TheWarolf/Voron-Personal-Mods/README.md

# Voron-Personal-Mods
Personal modfications to Voron machines
