TheWarolf/Voron-Personal-Mods/Micron/Readme.md

This folder contains various mods for the Micron project.

Original Micron repo can be found [here](https://github.com/PrintersForAnts/Micron)
