TheWarolf/Voron-Personal-Mods/MMU/M4s-Battery-MMU/Readme.md

This an ancient thing, predating the ERCF development.
It was clunky, definitely bigger than needed and noisy af, but it was beautiful. It'll always have a place in my heart.

CAD that you find here is just to keep the memory alive. Do as you please with it, but consider that's a mess and incredibly incomplete. 
You've been warned.
