TheWarolf/Voron-Personal-Mods/V2/Long_Mantis_Toolhead/Readme.md

This folder contains a bunch of mods based on the awesome work made by discord user *Long* on his Mantis toolhead.
I've made just minimal mods, **all credit goes to him**.

Original repo can be found [here](https://github.com/mandryd/VoronUsers/tree/master/printer_mods/Long/Mantis_Dual_5015)
