TheWarolf/Voron-Personal-Mods/Micron/Backpack/Images/PreloadScheme.pdf

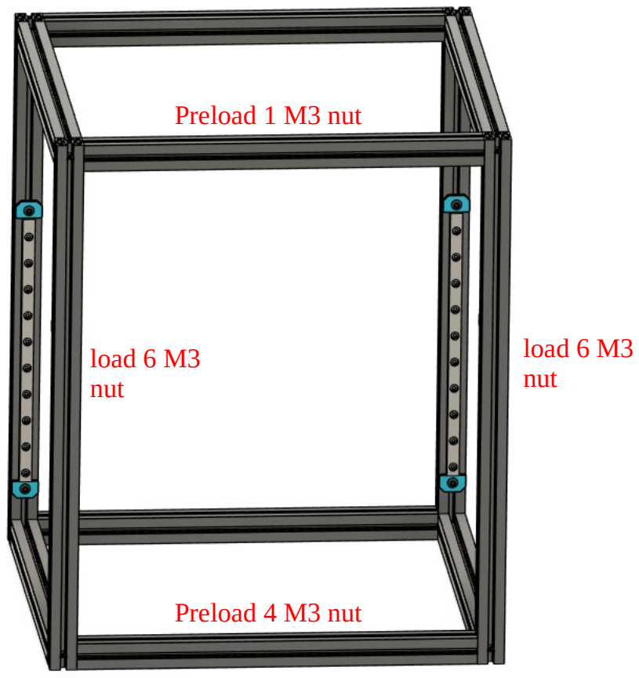
[picture p10: page 1]

Preload 1 M3 nut

Preload 4 M3 nut

load 6 M3
nut

load 6 M3
nut
