TheWarolf/Voron-Personal-Mods/Micron/Backpack/Images/OpenBackpack.PNG

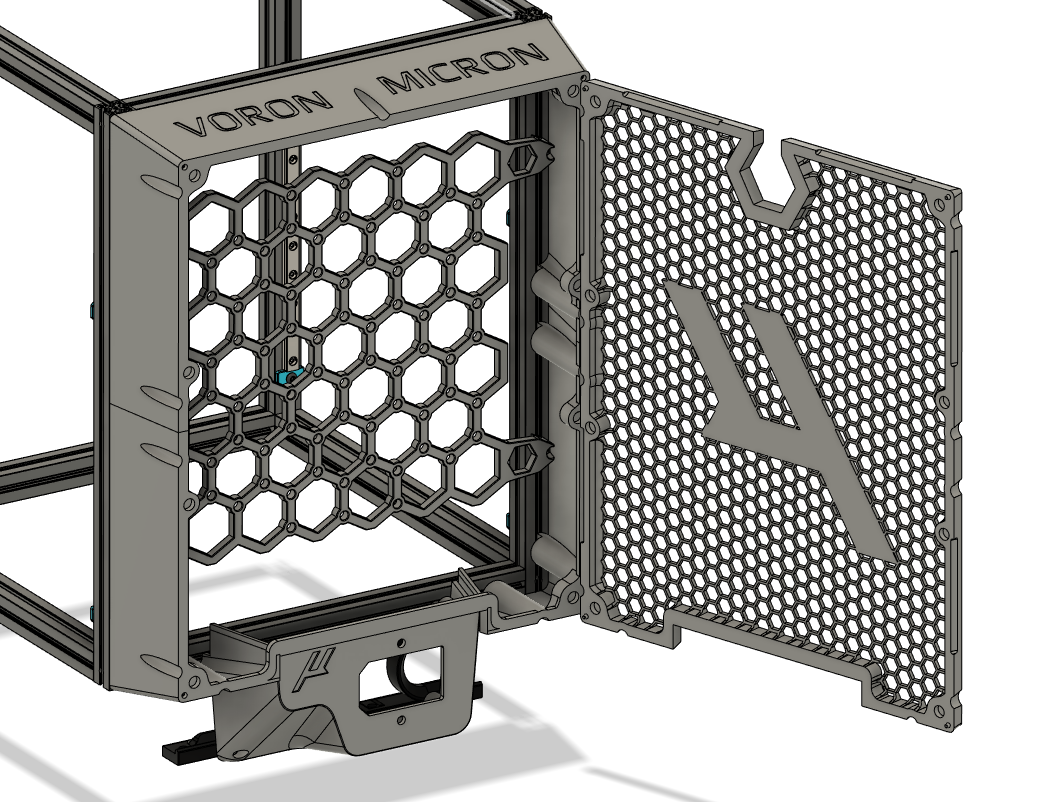
Micron/Backpack/Images/OpenBackpack.PNG
