TheWarolf/Voron-Personal-Mods/Micron/Backpack/STL/Walls_Bottom_Half_x1.stl

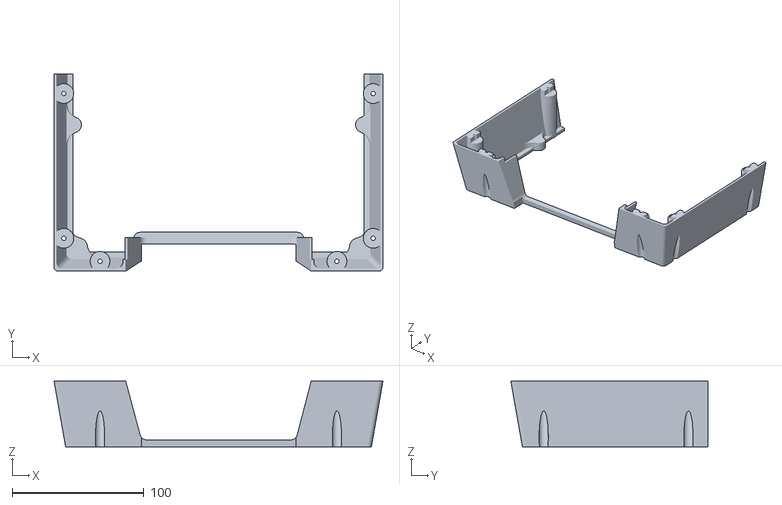
[picture p12: CAD file, 2022-07-20]
Micron/Backpack/STL/Walls_Bottom_Half_x1.stl
250.0 x 150.0 x 50.0
