TheWarolf/Voron-Personal-Mods/V2/Long_Mantis_Toolhead/LGX_Lite_Toolhead/STLs/LGX_Lite_Sensorized_Hotend_Mount.stl

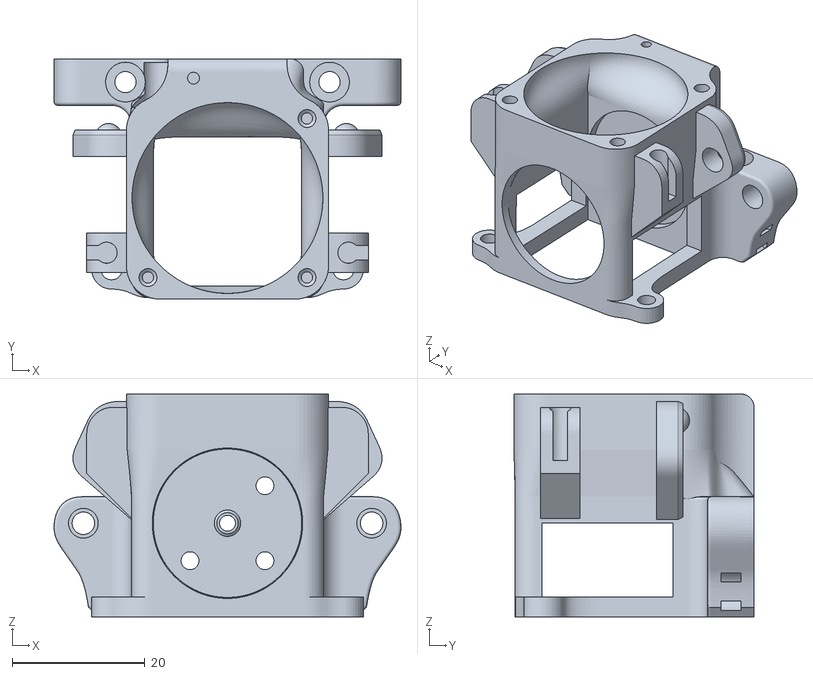
[picture p13: CAD file, 2022-01-25]
V2/Long_Mantis_Toolhead/LGX_Lite_Toolhead/STLs/LGX_Lite_Sensorized_Hotend_Mount.stl
52.4 x 36.2 x 33.7
