TheWarolf/Voron-Personal-Mods/V2/Long_Mantis_Toolhead/Sailfin_Mount/CAD/Mantis_Sailfin_SensorInside.step

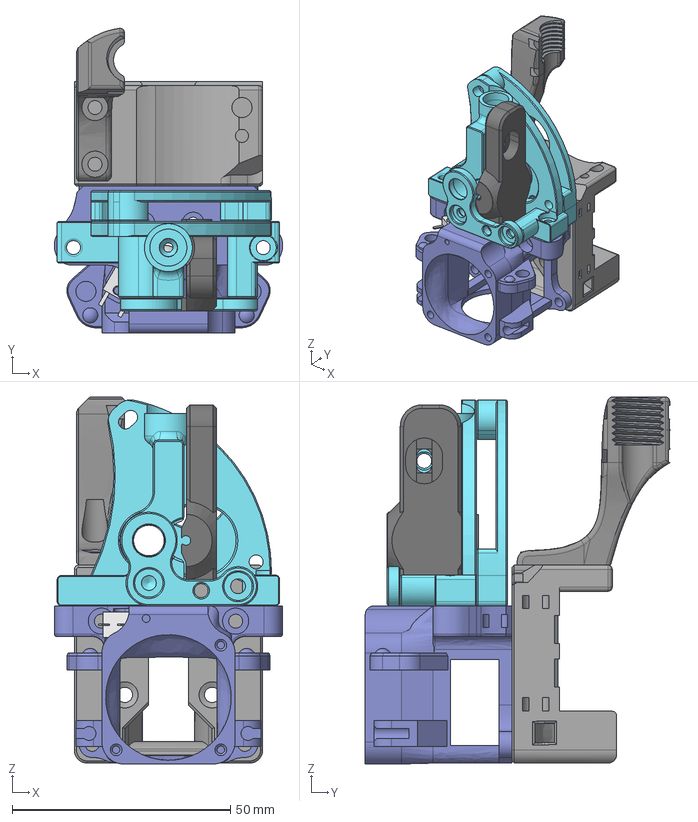
[picture p14: CAD file, 2022-02-10]
V2/Long_Mantis_Toolhead/Sailfin_Mount/CAD/Mantis_Sailfin_SensorInside.step
52.4 x 69.8 x 84.1 mm
SteelBall (1)(Mirror) (2)
Rear
Lever
Front
Sherpa Mid
