TheWarolf/Voron-Personal-Mods/V2/Long_Mantis_Toolhead/Sailfin_Mount/STLs/StrainRelief_Threaded.stl

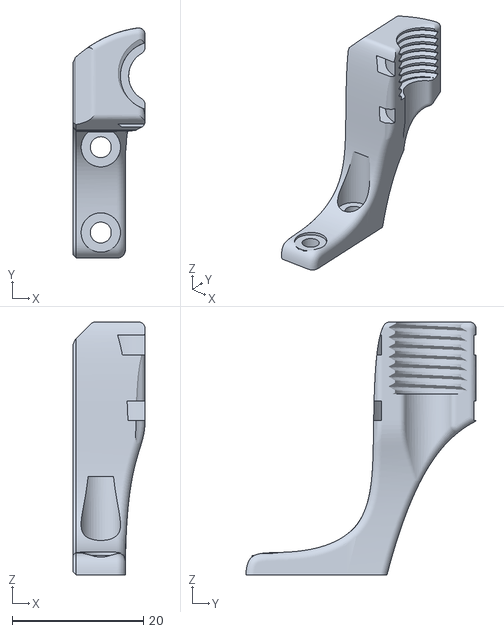
[picture p15: CAD file, 2022-02-10]
V2/Long_Mantis_Toolhead/Sailfin_Mount/STLs/StrainRelief_Threaded.stl
11.0 x 35.1 x 38.6
