TheWarolf/Voron-Personal-Mods/V2/Long_Mantis_Toolhead/Sensorized_Hotend_Mount/CAD/Sensorized_Hotend_Mount.step

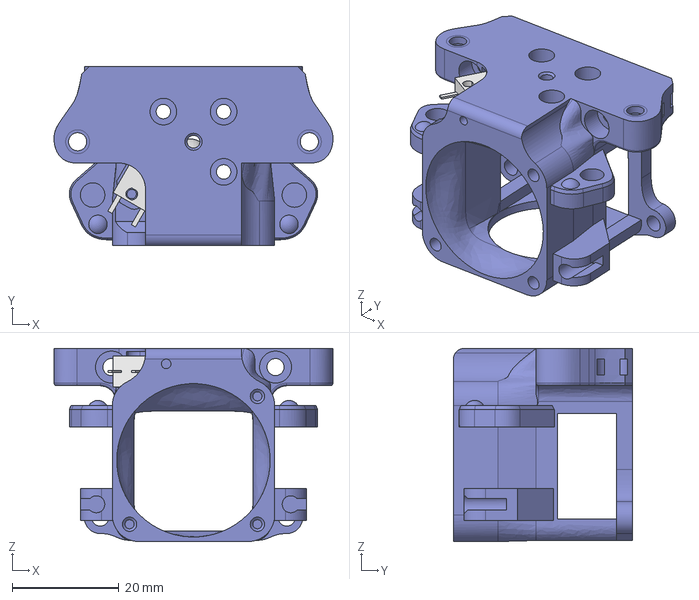
[picture p16: CAD file, 2022-01-25]
V2/Long_Mantis_Toolhead/Sensorized_Hotend_Mount/CAD/Sensorized_Hotend_Mount.step
52.4 x 33.7 x 36.3 mm
