TheWarolf/Voron-Personal-Mods/V2/Long_Mantis_Toolhead/LGX_Lite_Toolhead/STLs/LGX_Lite_Strain_Relief_Threaded.stl

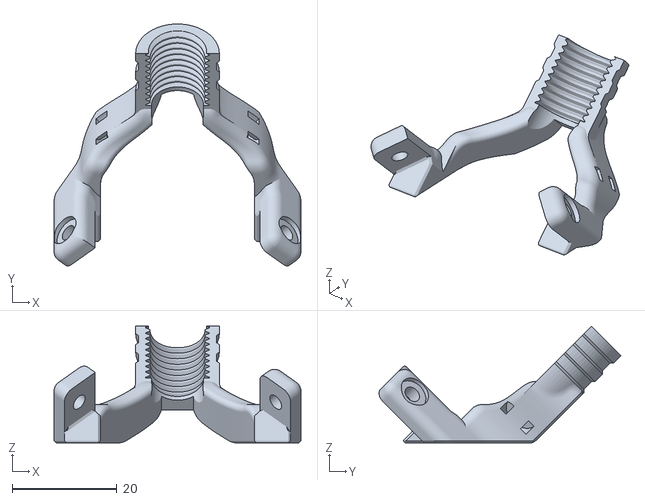
[picture p18: CAD file, 2022-01-25]
V2/Long_Mantis_Toolhead/LGX_Lite_Toolhead/STLs/LGX_Lite_Strain_Relief_Threaded.stl
47.2 x 46.2 x 22.3
