TheWarolf/Voron-Personal-Mods/V2/Long_Mantis_Toolhead/Sailfin_Mount/STLs/Carriage.stl

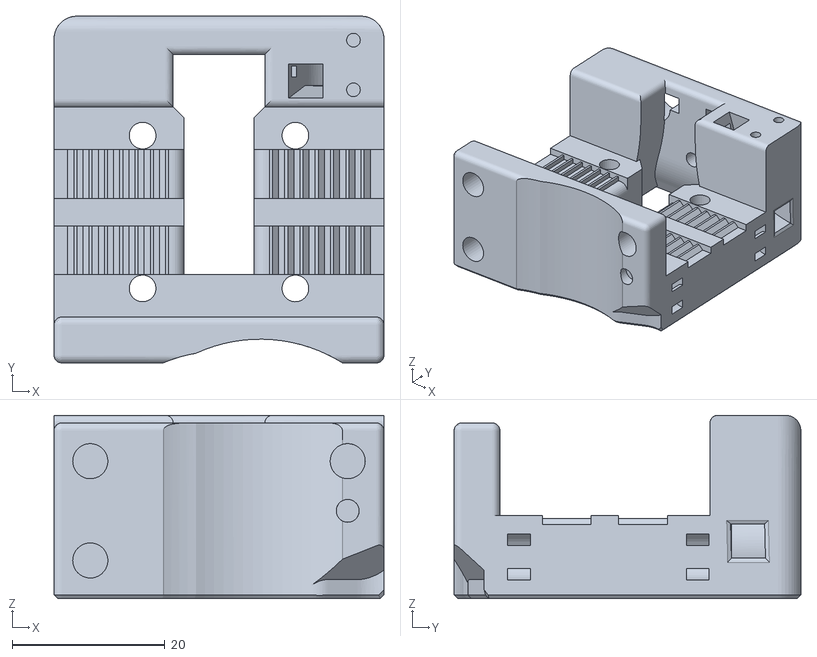
[picture p19: CAD file, 2022-02-10]
V2/Long_Mantis_Toolhead/Sailfin_Mount/STLs/Carriage.stl
43.2 x 45.4 x 24.0
