TheWarolf/Voron-Personal-Mods/Micron/Backpack/STL/AC_Inlet_Cover_x1.stl

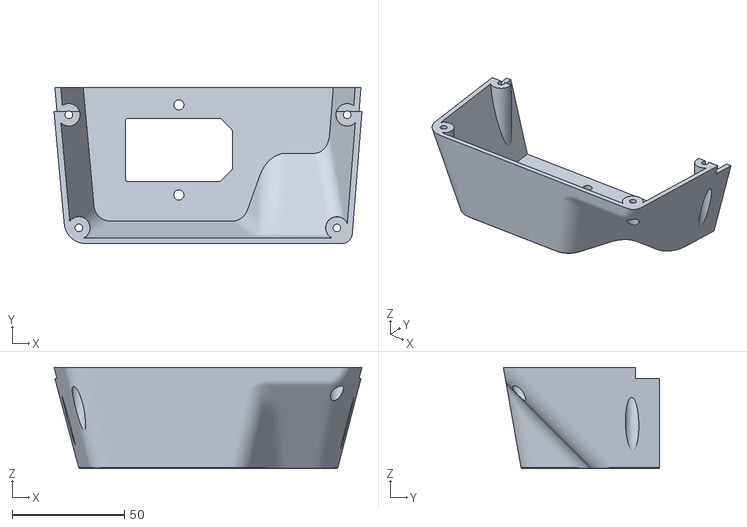
[picture p20: CAD file, 2022-07-20]
Micron/Backpack/STL/AC_Inlet_Cover_x1.stl
137.0 x 69.6 x 45.0
