TheWarolf/Voron-Personal-Mods/V2/Long_Mantis_Toolhead/LGX_Lite_Toolhead/STLs/LGX_Lite_Carriage.stl

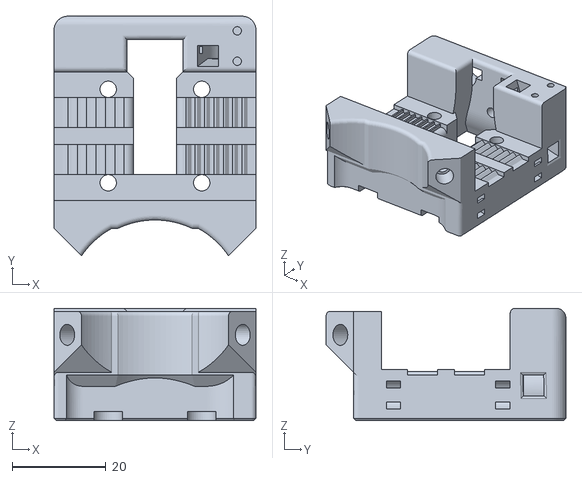
[picture p21: CAD file, 2022-01-25]
V2/Long_Mantis_Toolhead/LGX_Lite_Toolhead/STLs/LGX_Lite_Carriage.stl
43.2 x 51.3 x 24.0
