TheWarolf/Voron-Personal-Mods/V2/Long_Mantis_Toolhead/Sailfin_Mount/STLs/Sailfin_Guidler_ECAS.stl

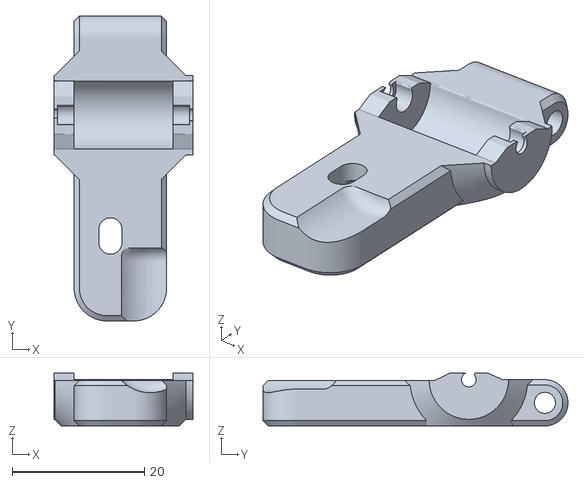
[picture p22: CAD file, 2022-02-10]
V2/Long_Mantis_Toolhead/Sailfin_Mount/STLs/Sailfin_Guidler_ECAS.stl
21.0 x 46.1 x 8.00
