TheWarolf/Voron-Personal-Mods/Micron/Backpack/STL/Electronics_Custom_Support_x1.stl

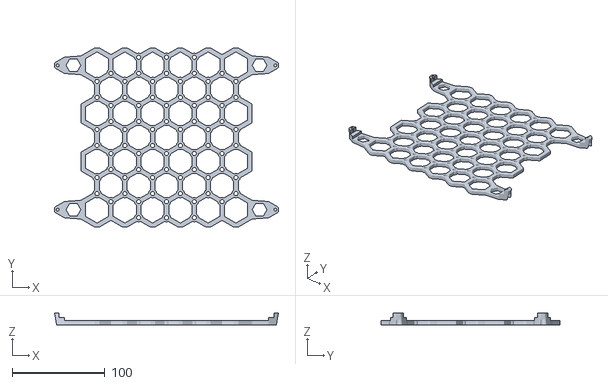
[picture p23: CAD file, 2022-07-20]
Micron/Backpack/STL/Electronics_Custom_Support_x1.stl
241.9 x 193.4 x 13.0
