TheWarolf/Voron-Personal-Mods/V2/Long_Mantis_Toolhead/Sailfin_Mount/STLs/Sailfin_Body_ECAS.stl

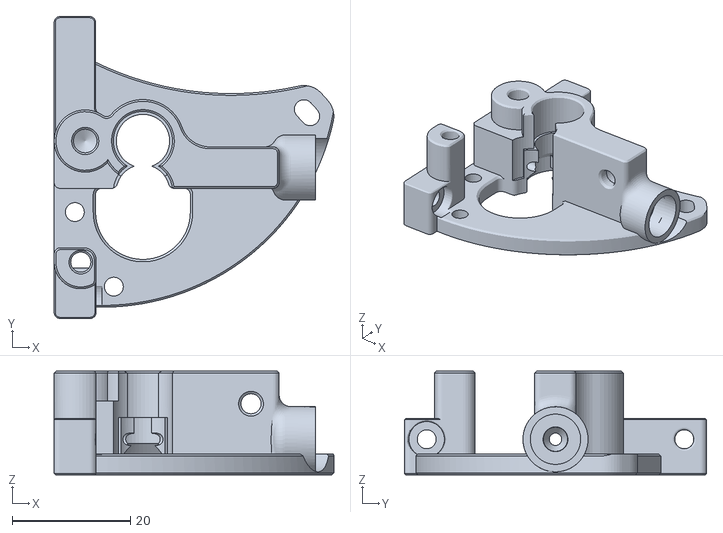
[picture p24: CAD file, 2022-02-10]
V2/Long_Mantis_Toolhead/Sailfin_Mount/STLs/Sailfin_Body_ECAS.stl
47.2 x 51.0 x 17.5
