TheWarolf/Voron-Personal-Mods/Micron/Backpack/STL/Modified_Rear_Skirt_x1.stl

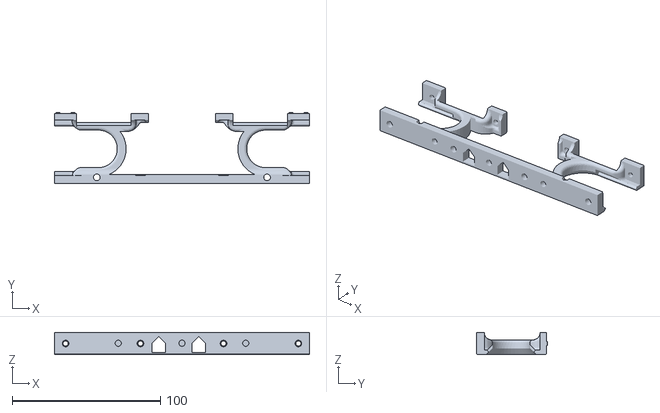
[picture p25: CAD file, 2022-07-20]
Micron/Backpack/STL/Modified_Rear_Skirt_x1.stl
171.9 x 47.7 x 15.0
