TheWarolf/Voron-Personal-Mods/Micron/Backpack/STL/Cover_Plate_x1.stl

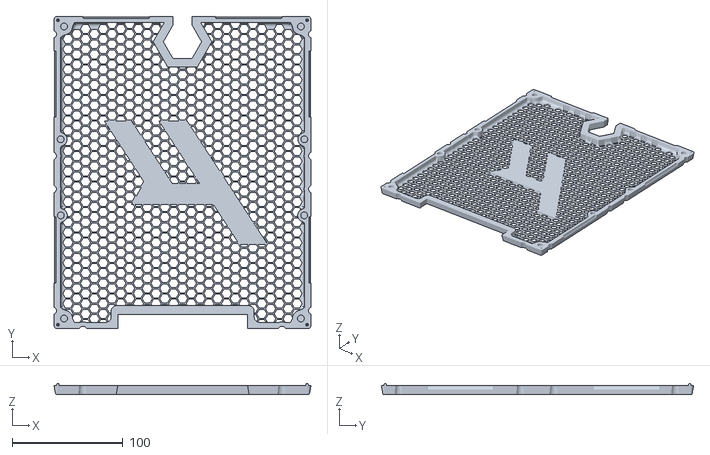
[picture p26: CAD file, 2022-07-20]
Micron/Backpack/STL/Cover_Plate_x1.stl
232.4 x 282.4 x 9.80
