TheWarolf/Voron-Personal-Mods/V2/Long_Mantis_Toolhead/LGX_Lite_Toolhead/STLs/LGX_Lite_Adapter_Plate.stl

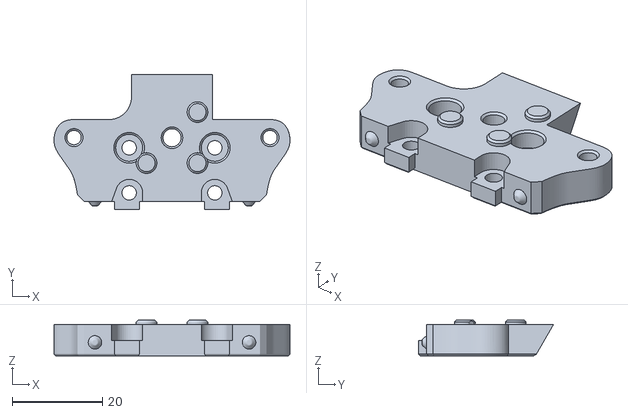
[picture p27: CAD file, 2022-01-25]
V2/Long_Mantis_Toolhead/LGX_Lite_Toolhead/STLs/LGX_Lite_Adapter_Plate.stl
52.4 x 30.0 x 7.95
