TheWarolf/Voron-Personal-Mods/(list of files, cad)

Other CAD files:
V2/Long_Mantis_Toolhead/LGX_Lite_Toolhead/STLs/LGX_Lite_Carriage_Single_Magnet.stl
V2/Long_Mantis_Toolhead/Sensorized_Hotend_Mount/STLs/Sensorized_Hotend_Mount.stl
